nananek/kvm-board/README.md

# serial-km-emulator — CH9329 USB キーボード/マウスエミュレータ

MR-CH9329EMU-USB（マルツの CH9329 モジュール）の代替を JLCPCB の SMT 実装で作るための KiCad プロジェクトです。シリアル側とキーボード/マウス側の両方を USB Type-C にしています。

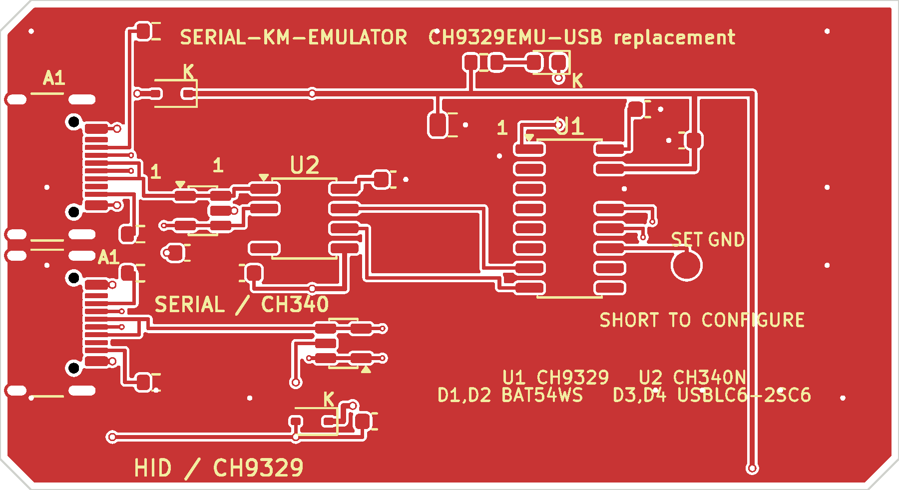
[picture p1: docs/pcb_top.png]
基板表面


- 基板: 57.6 × 31.4 × 1.6 mm、2 層。実物の FRISK ケース内寸（67.0 × 32.4 mm）の左側に 0.5 mm ずつ逃がして置き、右側はラッチ張り出しとのクリアランスを残した寸法です
- 回路図: [docs/schematic.pdf](docs/schematic.pdf)
- データシートとシルクの対応: [docs/datasheets.md](docs/datasheets.md)
- 配線図: [docs/pcb_routing.png](docs/pcb_routing.png)（GND ベタを消して配線を見やすくしたもの）
- 部品: 21 点、10 種類。すべて JLCPCB の在庫部品（2026-10 時点）。このほかに、実装しないテストパッドを 2 点置いています
- ファームウェア不要。CH9329 の内蔵ファームで動きます

## 仕様

| 項目 | 内容 |
| --- | --- |
| 基板寸法 | 57.6 × 31.4 mm、t1.6 mm、2 層 |
| コネクタ | USB Type-C レセプタクル ×2（HRO TYPE-C-31-M-12）。どちらも基板左端、上下に 5.0 mm ずつ振り分け |
| J1 (SERIAL) | CH340N 経由の USB シリアル。制御側 PC に接続 |
| J2 (HID) | CH9329 の USB HID。操作対象の PC に接続 |
| 給電 | どちらの Type-C からでも給電可。BAT54WS でダイオード OR |
| シリアル | 9600 bps / 8N1（CH9329 出荷時設定） |
| 動作モード | CH9329 Mode 0（キーボード + マウス + カスタム HID の複合デバイス）、プロトコルモード |
| 表示 | ACT# の LED（HID 側の USB 設定完了で点灯） |
| テストパッド | TP1 (SET) / TP2 (GND)。CH9329 の設定変更用 |
| シルク | 表: 部品名とピン極性、裏: リポジトリの QR コード |

J1/J2 はどちらもデバイス側（CC に 5.1k の Rd）です。ホスト PC とは C-to-C でも C-to-A でも接続できます。充電器は接続しないでください。

基板裏面にはリポジトリ（<https://github.com/nananek/serial-km-emulator>）の QR コードをシルクで入れています。ケースに組み込む前ならスマートフォンで読み取れます。

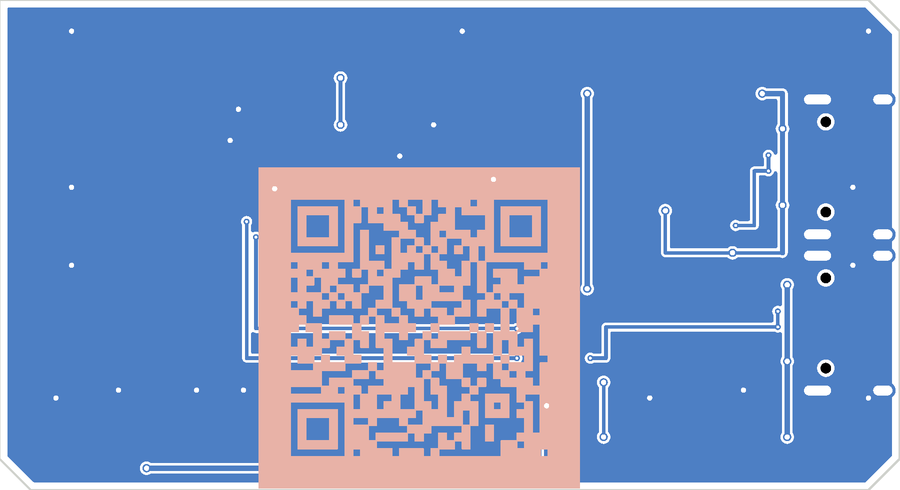
[picture p2: docs/pcb_bottom.png]
基板裏面


## 回路

```
制御側 PC ──Type-C(J1)── CH340N ──UART── CH9329 ──Type-C(J2)── 操作対象 PC
                              (TXD→RXD, RXD←TXD, 9600 8N1)
```

- CH9329: 5 V 給電。V33 に 0.1 µF、VCC に 0.1 µF。内蔵発振なので水晶なし。
- CH340N: 5 V 給電。V3 に 0.1 µF。内蔵クロックなので水晶なし。
- ESD: 各ポートに USBLC6-2SC6。クランプ用の VBUS ピンは各ポートのローカル VBUS に接続し、100nF (C6/C7) で GND にデカップリング。
- 5 V は BAT54WS ×2 で OR 接続。IC には約 4.7 V が入ります（CH340N の最低 4.0 V、CH9329 の最低 3.7 V の範囲内）。
- CH9329 の MODE0/MODE1、CFG0/CFG1、DEF、RST は未接続。内蔵プルアップ/プルダウンで Mode 0・プロトコルモード・9600 bps になります。UP は 5 V 動作なので未接続です。
- SET はテストパッド TP1 に、GND は TP2 に引き出しています。

### 設定の書き換え（TP1 / TP2）

U1 の右側に 1.7 mm のテストパッドを 2 つ出しています。

| パッド | 接続 | 位置 |
| --- | --- | --- |
| TP1 | CH9329 SET (pin 11) | U1 の右側、左のパッド |
| TP2 | GND | U1 の右側、右のパッド |

ピッチは 2.54 mm です。ピンセットやジャンパワイヤで TP1 と TP2 を短絡したまま、J1 側から WCH の設定ツールで書き換えます。書き換えが終わったら短絡を外してください。通常動作では SET は内蔵プルアップのままです。

## 部品表

`fab/bom_jlcpcb.csv` がそのまま JLCPCB の BOM です。

| 記号 | 値 | パッケージ | LCSC | 備考 |
| --- | --- | --- | --- | --- |
| J1, J2 | TYPE-C-31-M-12 | USB-C 16P | C165948 | HRO |
| U1 | CH9329 | SOP-16 | C2838834 | WCH |
| U2 | CH340N | SOP-8 | C2977777 | WCH |
| D1, D2 | BAT54WS | SOD-323 | C22629 | ショットキー |
| D3, D4 | USBLC6-2SC6 | SOT-23-6 | C7519 | ESD |
| R1–R4 | 5.1k | 0603 | C23186 | CC 用 |
| R5 | 1k | 0603 | C21190 | LED 用 |
| C1–C4, C6, C7 | 100nF | 0603 | C14663 | 50V X7R |
| C5 | 10uF | 0805 | C15850 | 25V X5R |
| LED1 | KT-0603R | 0603 | C2286 | 赤 |

基本部品（C23186、C21190、C14663、C15850、C2286）以外の 5 種類は拡張部品です。拡張部品は 1 種類あたりの実装手数料がかかります。

## JLCPCB での発注

基板:

- 2 層、57.6 × 31.4 mm、t1.6 mm、FR-4、HASL、1 oz
- 最小配線幅/間隔 0.15/0.15 mm、ビア 0.5/0.3 mm。データ線のエスケープに 0.35/0.15 mm のビアも使っています。JLCPCB の標準能力内です。

実装:

- 表面のみ、21 点。
- アップロードするファイル:
  - ガーバー: `fab/serial-km-emulator-gerbers.zip`
  - BOM: `fab/bom_jlcpcb.csv`
  - CPL: `fab/cpl_jlcpcb.csv`
- ガーバー、ドリル、CPL はすべて基板左下を原点にした座標です（KiCad のドリル/配置原点を使用）。ガーバー zip と CPL はセットで再アップロードしてください。JLCPCB の部品ライブラリ向けの回転補正を入れてあります（SO-8/SO-16 +270°、SOT-23-6 +270°。Type-C、SOD-323、LED、0603 は回転補正なし）。Type-C は基板側でフットプリントを 180° 回して開口を左外側、SMT パッドを基板内側に置いています。CPL は JLC 側の原点に合わせて X を 1.571 mm 補正しており、出力は J1/J2 とも 270°、位置はどちらも X 3.7 mm（Y は J1 20.7 mm、J2 10.7 mm）です。補正値は `scripts/make_jlc_files.py` にあります。実装プレビューで向きを確認してください。

注意:

- Type-C コネクタ (C165948) はシェル固定タブが THT 形状ですが、JLCPCB の SMT 実装部品リストに含まれている部品です。SMT 実装で発注できます。
- Type-C の VBUS パッドから 0.5/0.3 mm のビアをパッドの外側に置き、B.Cu で引き回しています。ビアはパッド内ではないため、via-in-pad の DFM 指摘はありません。VBUS は 2 接点ずつパッドが重なっているので、ビアは各コネクタ 2 個です。
- ガーバーは KiCad 10 の既定（X2、4.6 フォーマット）です。

## フリスクケースへの組み込み

基板外形は、実物の FRISK ケースの内寸からラッチ張り出しの分だけ右側をまっすぐ切り落とした **57.6 × 31.4 mm** です。左上・左下・右下の角は **2 mm の 45° パンチカット**で落とし、右上だけ直角に残しています。角丸のルーター加工より外形カットを安くするためです。

### 実寸確認用シート

紙に印刷してケースとの寸法を確認するときは [docs/print_check_a4.pdf](docs/print_check_a4.pdf) を使ってください。

- A4 横、1:1。印刷時は「実際のサイズ / 100%」を選び、「用紙に合わせる」は使わないでください。
- グレーベタが基板、その外側の明るいグレーの帯がケース内壁との 0.5 mm クリアランスです。切り抜いてトレイに落とせます。
- 右側の網掛けがケースのラッチ張り出しです。基板のまっすぐな右辺は、この張り出しから 0.5 mm 離して置きます。
- 下部の 100 mm 目盛りが 100 mm になっていなければ、印刷倍率がずれています。
- `python3 scripts/gen_print_sheet.py` で作り直せます（基板外形は `serial-km-emulator.kicad_pcb` の Edge.Cuts から読みます）。

### ケース寸法

2026-10 に実物の FRISK ケースを実測しました。

- 内寸: **67.0 × 32.4 mm**
- ケース肉厚: **1.0 mm**
- ラッチ張り出しの奥行き: **8.4 mm**
- ラッチ張り出しの高さ: **21.4 mm**（反対側の開口部は 11.0 mm）

基板は内寸から 0.5 mm ずつ逃がしたうえで、右側のラッチ張り出し 8.4 mm を避けるために **57.6 × 31.4 mm** にしています。右辺はラッチ用の切り欠きやローブを作らず、1 本の直線カットです。左上・左下・右下の角は 2 mm の 45° パンチカットで落とし、右上だけ直角に残します。基板をトレイの左・上・下に 0.5 mm ずつ寄せると、右辺はラッチ張り出しから 0.5 mm 離れ、トレイ右側の 8.9 mm は空きます。

参考として、公開されている 3D モデル（[FRISK-CASE.zip](https://try3dcg.world.coocan.jp/files/FRISK-CASE.zip)、`FRISK_CASE1.stl`）は内トレイ 66.4 × 32.4 mm、張り出し 7.8 × 20.3 mm でした。実物は長辺が 0.6 mm 大きいため、実測値を優先しています。モデル配布ページは [3D PRINT用モデルデータ — FRISK CASE](https://try3dcg.world.coocan.jp/note/3dPrint/3dPrint.html#FRISK-CASE) です。

ロット差があるため、初回は必ず現物合わせで確認してください。

### 基板の向きと切り欠き

- 基板のまっすぐな右辺をケースのラッチ張り出し側に向け、基板をトレイの左・上・下に 0.5 mm ずつ寄せて置きます。右辺と張り出しの間に 0.5 mm の隙間ができます。ラッチ用の切り欠きはありません。ケースの角の丸みは、左上・左下・右下の 2 mm パンチカットで逃がします（右上は直角のままです）。
- J1 (SERIAL) と J2 (HID) はどちらも基板左端にあり、上から **10.7 mm** と **20.7 mm** の位置（基板の y 方向中心 15.7 mm から 5.0 mm ずつ、ピッチ 10.0 mm）です。口は基板端から **1.5 mm** 外へ出ます。2 つの口は蓋の切り欠きに収まる位置にあるため、蓋は削らず、トレイ左側壁に約 20 × 4 mm の開口を **壁を貫通するように** 1 か所開けてください（2 つの口が 1.06 mm しか離れていないため、開口も 1 つに繋がります）。
- 基板端はケース内壁から 0.5 mm、肉厚は 1.0 mm なので、1.5 mm の口はケース外面とほぼ面一になります。プラグは壁の切り欠きを通ってコネクタに届きます。
- 切り欠きの外側を 0.3 mm 程度面取りすると、プラグの樹脂（オーバーモールド）が当たりにくくなり、奥まで挿しやすくなります。
- 基板は左・上・下の 0.5 mm を保って固定してください。右側に寄せるとラッチ張り出しに当たります。
- 基板をトレイに置いたとき、コネクタの口は基板面から約 1.6〜4.9 mm の高さに来ます。ケース底面からの高さはスペーサーで調整してください。
- 固定用の穴はありません。両面テープやスポンジで固定します。基板とトレイの間に 1 mm 程度のスペーサーを入れると、プラグの挿入量を稼げます（高さ方向の調整で、左右の出寸法には影響しません）。
- 実機のケースで必ず確認してください。内寸が違う場合は基板外形を調整できます。

## 使い方

1. J2 (HID) を操作対象の PC に接続します。キーボード/マウスとして認識され、LED が点灯します。
2. J1 (SERIAL) を制御側の PC に接続します。CH340 の USB シリアル（Linux なら `/dev/ttyUSB0`）として見えます。
3. 9600 bps / 8N1 で CH9329 のプロトコルを送ります。

'A' を押して離す例（CH9329 プロトコル、チェックサムは全バイトの和の下位 8 bit）:

```python
import serial
s = serial.Serial("/dev/ttyUSB0", 9600, timeout=1)
s.write(bytes.fromhex("57 AB 00 02 08 00 00 04 00 00 00 00 00 10"))  # press A
s.write(bytes.fromhex("57 AB 00 02 08 00 00 00 00 00 00 00 00 0C"))  # release
```

プロトコルの詳細は WCH の CH9329 データシートと「CH9329 シリアル通信プロトコル」を参照してください。

## 設計メモ

- シリアル側と HID 側は独立した USB デバイスです。2 台の PC の GND がケーブル経由で共通になります。これは元の MR-CH9329EMU-USB と同じです。
- ESD 保護素子の VBUS ピンは、ダイオード OR の前の各ポートのローカル VBUS に接続しています。VBUS-GND 間の 100nF (C6/C7) は USBLC6 の近くに置き、ESD 時のクランプ電圧を安定させています。
- Type-C の 4 つの VBUS 接点はすべて接続しています。VBUS パッドは 2 接点ずつ重なっているので、各コネクタ 2 個の 0.5/0.3 mm ビアをパッドの外側に置き、B.Cu で引き回しています。
- GND は両面ベタ。USB の D+/D- は全速 12 Mbps なので、特にインピーダンス制御はしていません。
- 部品番号のテキストは U1/U2 以外はシルクから外しています（実装は CPL で行うため）。
- J1/J2 は 10.0 mm ピッチで、シェル同士は 1.06 mm 空いています。ライブラリのコートヤード（±5.32 mm）はシェル（8.94 mm）より広く、2 個並べると 0.64 mm 重なるため、`serial-km-emulator.kicad_dru` でこの 2 個の組み合わせだけコートヤードの重なりを許可しています。

## ファイル構成

```
serial-km-emulator.kicad_pro  KiCad プロジェクト（DRC ルール・ネットクラス込み）
serial-km-emulator.kicad_dru  J1/J2 のコートヤード重なりだけを許可する DRC ルール
serial-km-emulator.kicad_sch  回路図
serial-km-emulator.kicad_pcb  基板（配線・ベタ済み）
lib/kvm.kicad_sym             シンボルライブラリ
lib/KVM.pretty/               フットプリント（KiCad 公式ライブラリから取得）
fp-lib-table                  KVM.pretty の登録
sym-lib-table                 kvm.kicad_sym の登録
fab/                          ガーバー zip、BOM、CPL、KiCad 位置ファイル
docs/                         回路図 PDF、基板画像
scripts/                      設計データ生成スクリプト
AGENT.md                      エージェント向けの再生成・検証手順
```

## 再生成

KiCad 10 の `kicad-cli` と Python の `pcbnew` が必要です。

```sh
python3 scripts/gen_sch.py     # 回路図
python3 scripts/gen_pcb.py     # 基板（ゼロから生成）
./scripts/export_fab.sh        # ガーバー、BOM、CPL
./scripts/gen_docs_images.sh   # docs の基板画像
```

リポジトリの URL を変えたときだけ、`python3 scripts/make_repo_qr.py` で `scripts/repo_qr.txt` を作り直してください（`qrcode` パッケージが必要です）。基板の生成はこのテキストファイルを読むだけなので、通常のビルドに `qrcode` は要りません。

Docker しかない場合は `scripts/kicad.sh` 経由で同じコマンドを実行できます。手順は [AGENT.md](AGENT.md) にまとめています。

`serial-km-emulator.kicad_pcb` は `scripts/gen_pcb.py` が生成します。GUI で直接編集すると次回の生成で上書きされるので、変更はスクリプト側に入れてください。回路図も同様に `scripts/gen_sch.py` から生成しています。

## 検証

- ERC: 0 件
- DRC: 0 件（エラー・警告とも）
- 回路図のネットリストと基板のパッドネットは一致
- `kicad-cli pcb drc` / `kicad-cli sch erc` で確認済み

## ライセンス

MIT。詳細は [LICENSE](LICENSE) を参照してください。

基板の製造・実装・ケース加工は自己責任で行ってください。特に Type-C のシェル固定タブ、VBUS パッド外のビア、ケースの切り欠きは、発注前に各自の環境で確認してください。
