nananek/kvm-board/docs/pcb_routing.png

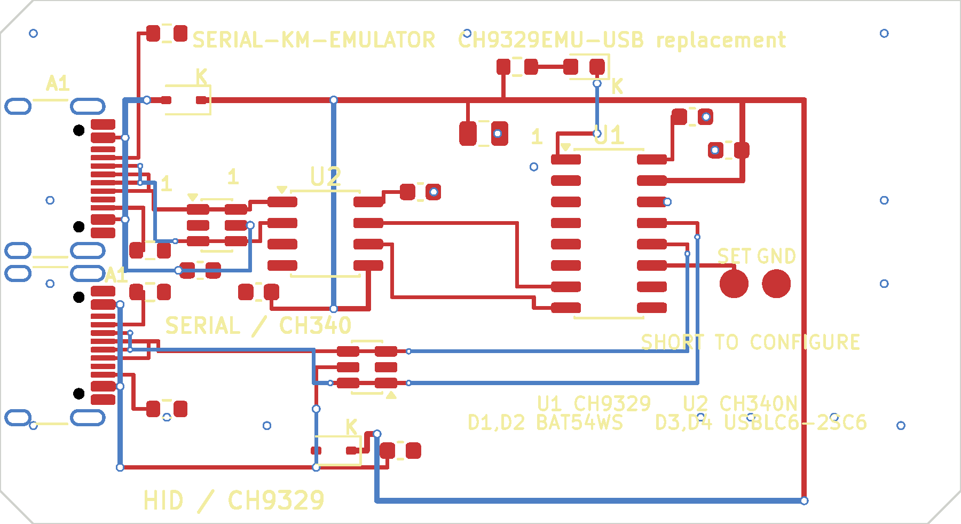
docs/pcb_routing.png
