nananek/kvm-board/fab/bom_jlcpcb.csv

Comment | Designator | Footprint | LCSC Part #
TYPE-C-31-M-12 | J1,J2 | USB_C_Receptacle_HRO_TYPE-C-31-M-12 | C165948
CH9329 | U1 | SO-16_3.9x9.9mm_P1.27mm | C2838834
CH340N | U2 | SO-8_3.9x4.9mm_P1.27mm | C2977777
BAT54WS | D1,D2 | D_SOD-323 | C22629
USBLC6-2SC6 | D3,D4 | SOT-23-6 | C7519
5.1k | R1,R2,R3,R4 | R_0603_1608Metric | C23186
1k | R5 | R_0603_1608Metric | C21190
KT-0603R | LED1 | LED_0603_1608Metric | C2286
100nF | C1,C2,C3,C4,C6,C7 | C_0603_1608Metric | C14663
10uF | C5 | C_0805_2012Metric | C15850
