nananek/kvm-board/docs/print_check_a4.pdf

# SERIAL-KM-EMULATOR / FRISK case fit check

Actual size (1:1). Print at 100% - do not use 'fit to page'.
If the 100 mm scale at the bottom does not measure 100 mm, the print is scaled. latch

J1

J2

SERIAL-KM-EMULATOR CH9329EMU-USB replacement

SERIAL / CH340

HID / CH9329

57.6

67.0 case inner

31.4

10.7

20.7

board (solid grey, 1:1)
0.5 mm case clearance (light grey)

connector centre line
case latch island (do not cover)

## HOW TO CHECK

1. Print this page at 100% / 'Actual size'.
2. Measure the 100 mm scale below with a steel rule.
3. Cut out the solid grey board and drop it into the tray.
4. Board 57.6 x 31.4, case inner 67.0 x 32.4. The light grey band is the 0.5 mm clearance to the left, top and bottom walls.
5. The right edge is one straight cut, 0.5 mm from the latch island. The right 8.9 mm of the tray stays empty. The top-left, bottom-left and bottom-right corners have 2 mm 45 degree punch cuts; the top-right stays square.
6. Both Type-C mouths are on the left edge at 10.7 and 20.7 mm from the top (5.0 mm either side of centre). Each mouth overhangs the edge by 1.5 mm.
7. Cut one 20 x 4 mm opening through the tray wall, centred between the two dashed centre lines. Both
ports sit inside the lid notch, so the lid is not cut.
Chamfer the outside by about 0.3 mm.
8. No mounting holes: use tape or foam with a 1 mm spacer.

### DIMENSIONS (mm)

board | 57.6 x 31.4 x 1.6
case | 67.0 x 32.4 inner, 1.0 wall
left/top/bottom gap 0.5
right edge 0.5 from the latch island corner cuts 2.0 x 45 deg (TL, BL, BR)
J1 / J2 centre 10.7 / 20.7 from the top connector pitch 10.0 (5.0 each side of centre)
mouth | 1.5 past the left edge
0 | 50 | 100

100 mm scale check (mm)

Generated by scripts/gen_print_sheet.py from serial-km-emulator.kicad_pcb
