nananek/kvm-board/docs/schematic.pdf

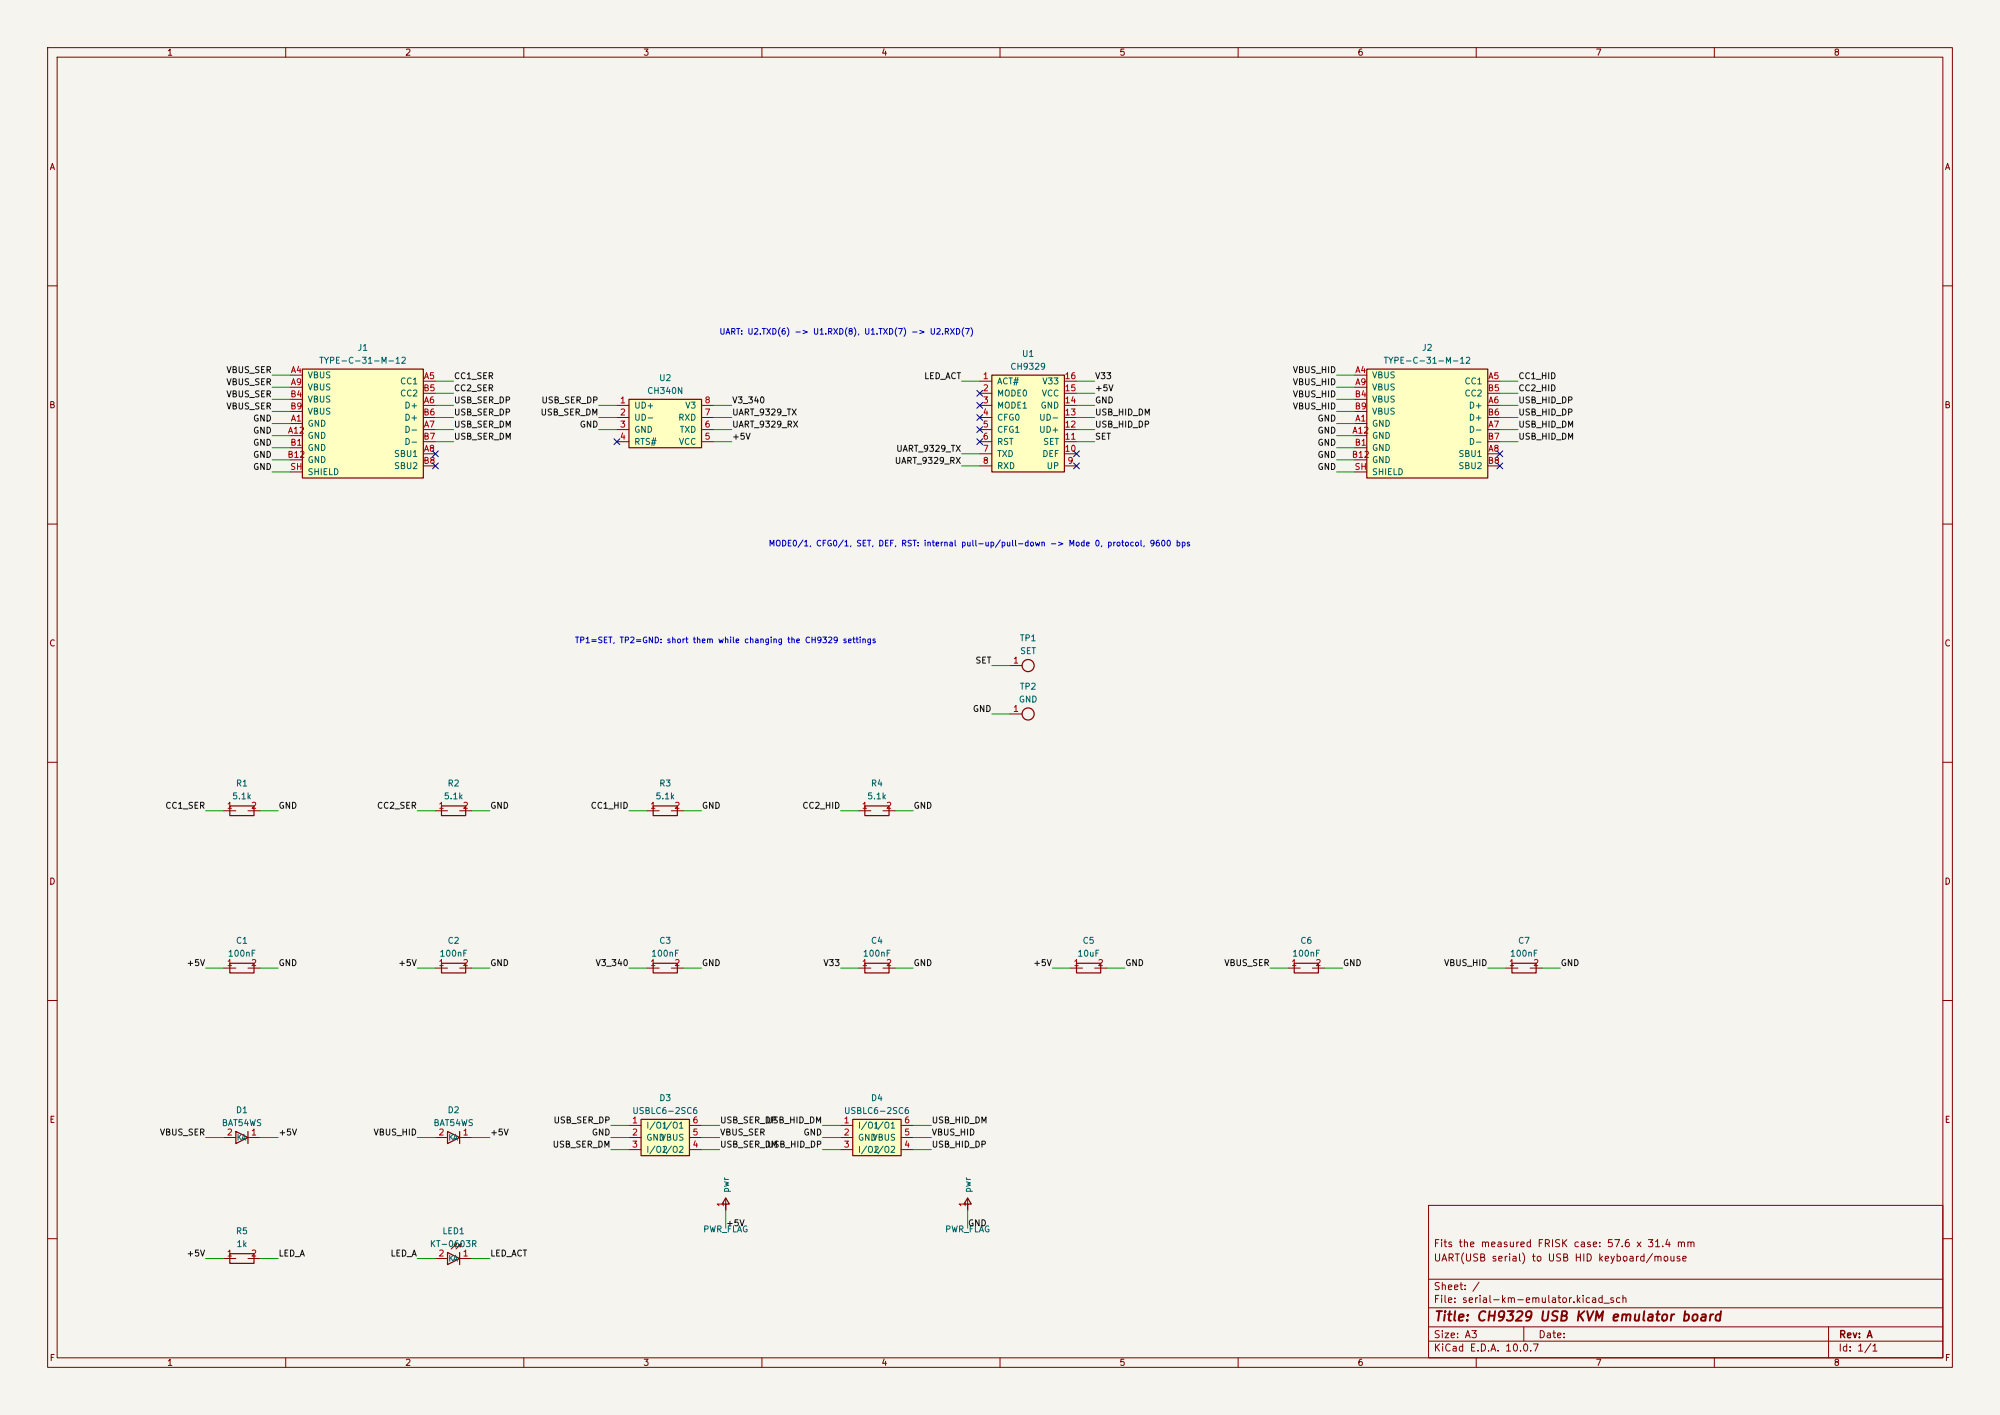
[picture p4: page 1]

MODE0/1, CFG0/1, SET, DEF, RST: internal pull-up/pull-down -> Mode 0, protocol, 9600 bps UART: U2.TXD(6) -> U1.RXD(8), U1.TXD(7) -> U2.RXD(7)

TP1=SET, TP2=GND: short them while changing the CH9329 settings

Fits the measured FRISK case: 57.6 x 31.4 mm
UART(USB serial) to USB HID keyboard/mouse

Sheet: /
File: serial-km-emulator.kicad_sch
Title: CH9329 USB KVM emulator board

Size: A3 | Rev: A | F Date:
KiCad E.D.A. 10.0.7 | Id: 1/1
