nananek/kvm-board/serial-km-emulator.kicad_pcb

## KiCad design serial-km-emulator.kicad_pcb (2026-10-31)

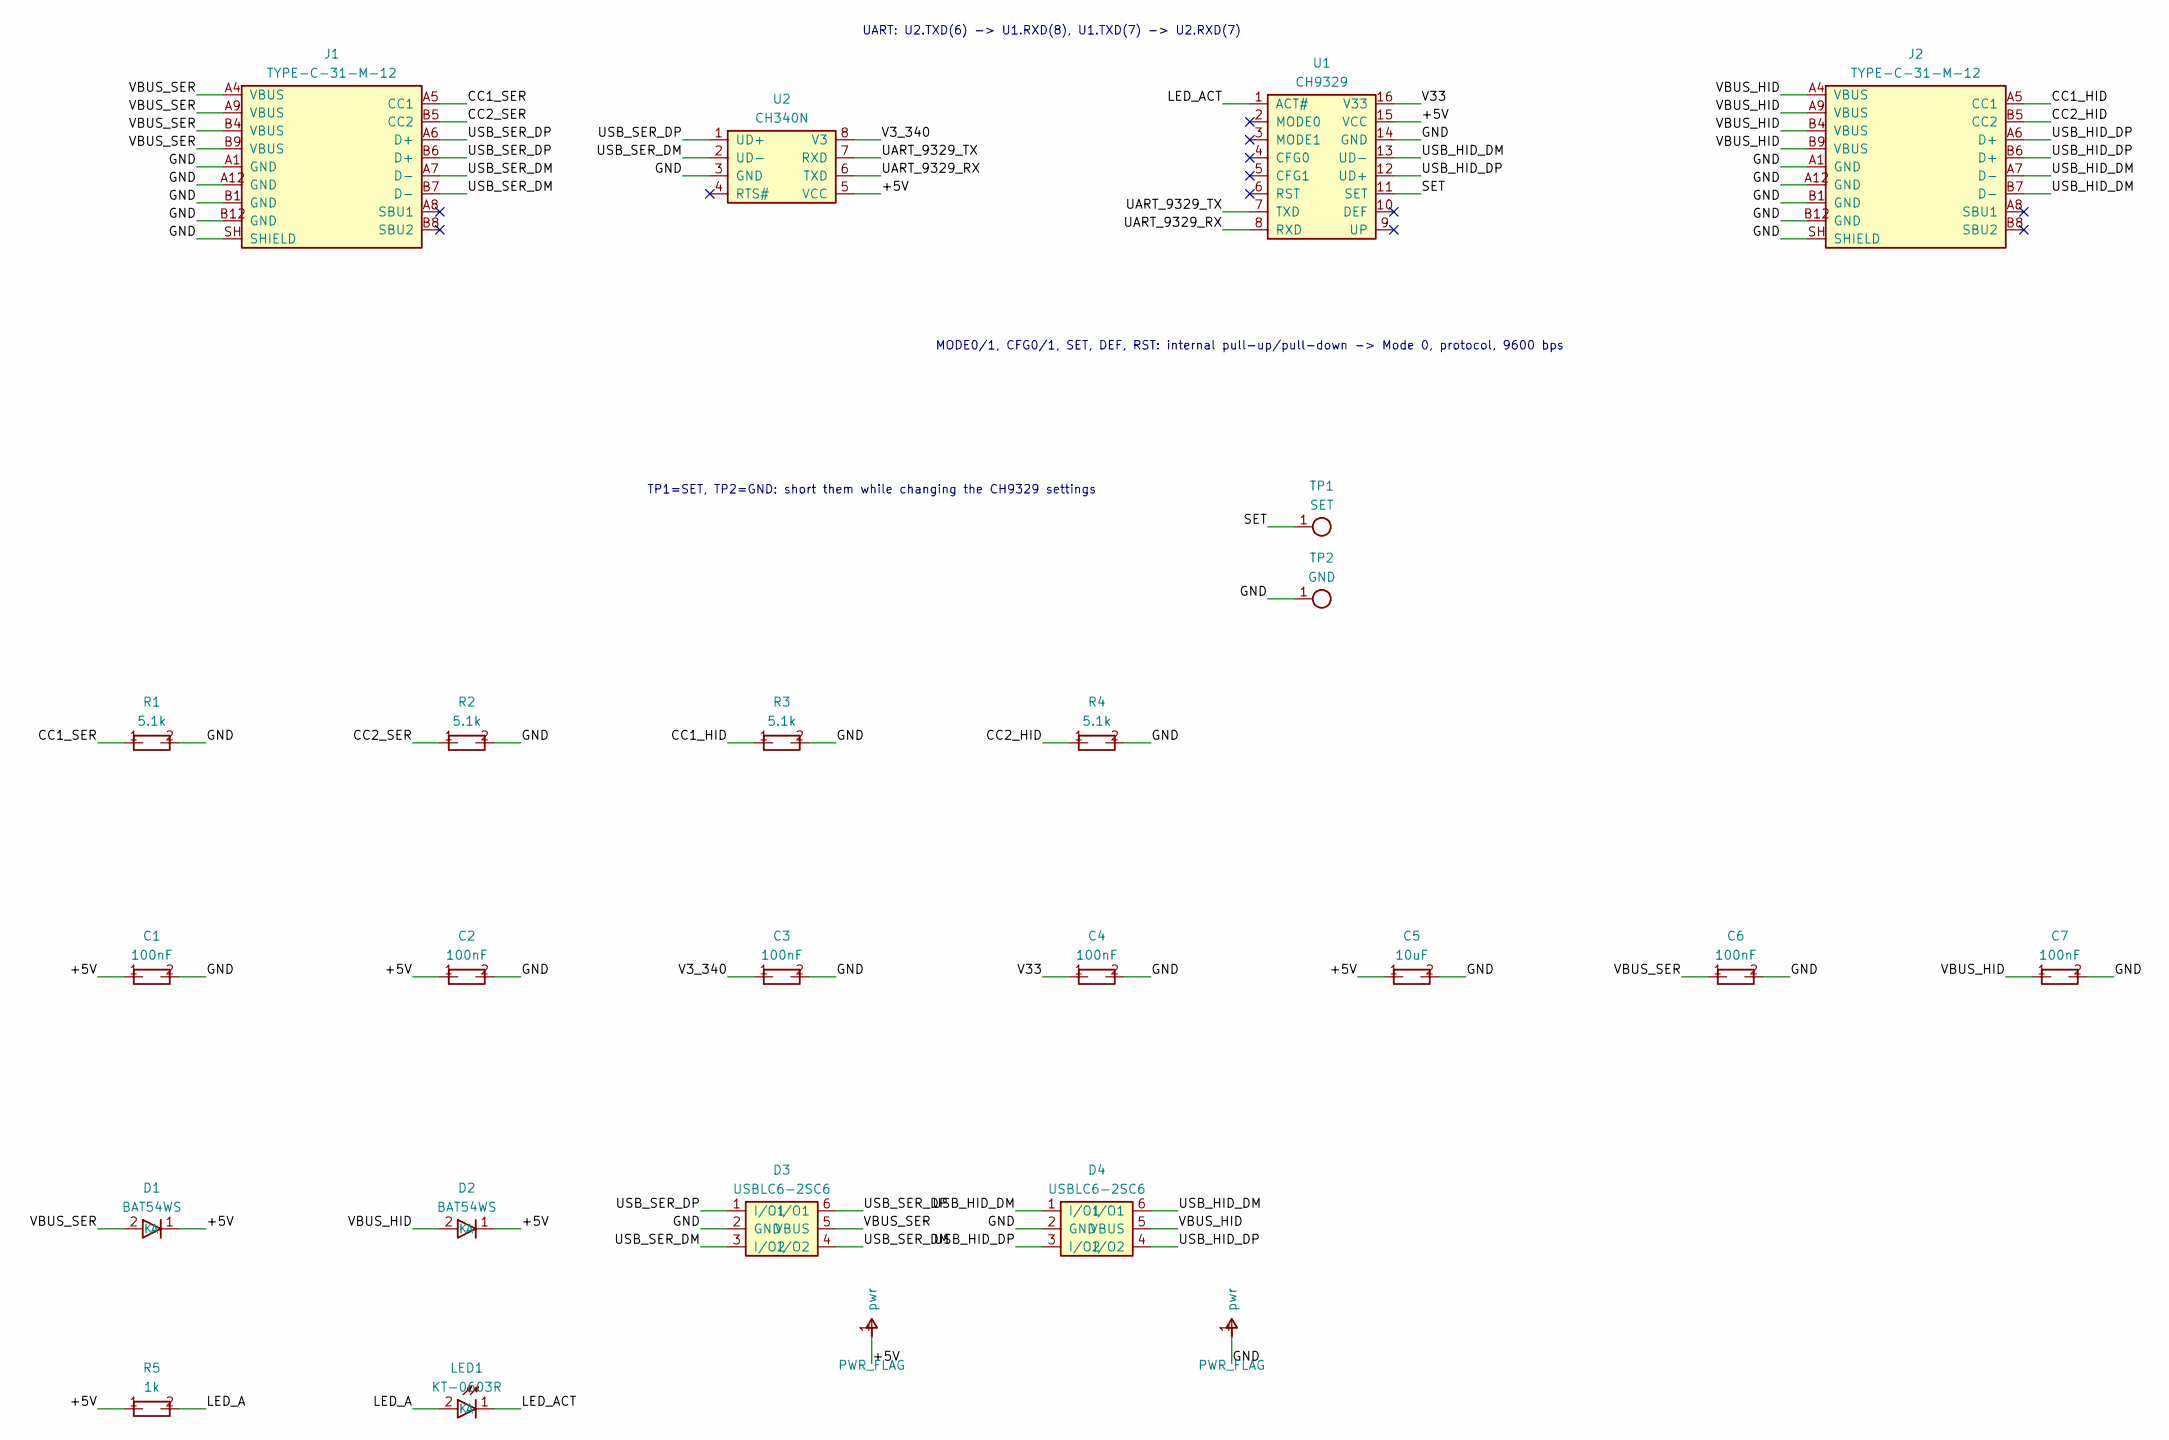
[picture p5: schematic serial-km-emulator.kicad_sch, CH9329 USB KVM emulator board]

Parts:
C1, C2, C3, C4, C6, C7: 100nF; C_0603_1608Metric; LCSC C14663
C5: 10uF; C_0805_2012Metric; LCSC C15850
D1, D2: BAT54WS; D_SOD-323; LCSC C22629
D3, D4: USBLC6-2SC6; SOT-23-6; LCSC C7519
J1, J2: TYPE-C-31-M-12; USB_C_Receptacle_HRO_TYPE-C-31-M-12; LCSC C165948
LED1: KT-0603R; LED_0603_1608Metric; LCSC C2286
R1, R2, R3, R4: 5.1k; R_0603_1608Metric; LCSC C23186
R5: 1k; R_0603_1608Metric; LCSC C21190
TP1: SET; TestPoint_1P
TP2: GND; TestPoint_1P
U1: CH9329; SO-16_3.9x9.9mm_P1.27mm; LCSC C2838834
U2: CH340N; SO-8_3.9x4.9mm_P1.27mm; LCSC C2977777

Connections:
+5V: C1.1, C2.1, C5.1, D1.1 (K), D2.1 (K), R5.1, U1.15 (VCC), U2.5 (VCC)
CC1_HID: J2.A5 (CC1), R3.1
CC1_SER: J1.A5 (CC1), R1.1
CC2_HID: J2.B5 (CC2), R4.1
CC2_SER: J1.B5 (CC2), R2.1
GND: C1.2, C2.2, C3.2, C4.2, C5.2, C6.2, C7.2, D3.2 (GND), D4.2 (GND), J1.A1 (GND), J1.A12 (GND), J1.B1 (GND), J1.B12 (GND), J1.SH (SHIELD), J2.A1 (GND), J2.A12 (GND), J2.B1 (GND), J2.B12 (GND), J2.SH (SHIELD), R1.2, R2.2, R3.2, R4.2, TP2.1, U1.14 (GND), U2.3 (GND)
LED_A: LED1.2 (A), R5.2
LED_ACT: LED1.1 (K), U1.1 (ACT#)
SET: TP1.1, U1.11 (SET)
UART_9329_RX: U1.8 (RXD), U2.6 (TXD)
UART_9329_TX: U1.7 (TXD), U2.7 (RXD)
USB_HID_DM: D4.1 (I/O1), D4.6 (I/O1), J2.A7 (D-), J2.B7 (D-), U1.13 (UD-)
USB_HID_DP: D4.3 (I/O2), D4.4 (I/O2), J2.A6 (D+), J2.B6 (D+), U1.12 (UD+)
USB_SER_DM: D3.3 (I/O2), D3.4 (I/O2), J1.A7 (D-), J1.B7 (D-), U2.2 (UD-)
USB_SER_DP: D3.1 (I/O1), D3.6 (I/O1), J1.A6 (D+), J1.B6 (D+), U2.1 (UD+)
V3_340: C3.1, U2.8 (V3)
V33: C4.1, U1.16 (V33)
VBUS_HID: C7.1, D2.2 (A), D4.5 (VBUS), J2.A4 (VBUS), J2.A9 (VBUS), J2.B4 (VBUS), J2.B9 (VBUS)
VBUS_SER: C6.1, D1.2 (A), D3.5 (VBUS), J1.A4 (VBUS), J1.A9 (VBUS), J1.B4 (VBUS), J1.B9 (VBUS)

Notes on the sheet:
UART: U2.TXD(6) -> U1.RXD(8), U1.TXD(7) -> U2.RXD(7)
MODE0/1, CFG0/1, SET, DEF, RST: internal pull-up/pull-down -> Mode 0, protocol, 9600 bps
TP1=SET, TP2=GND: short them while changing the CH9329 settings

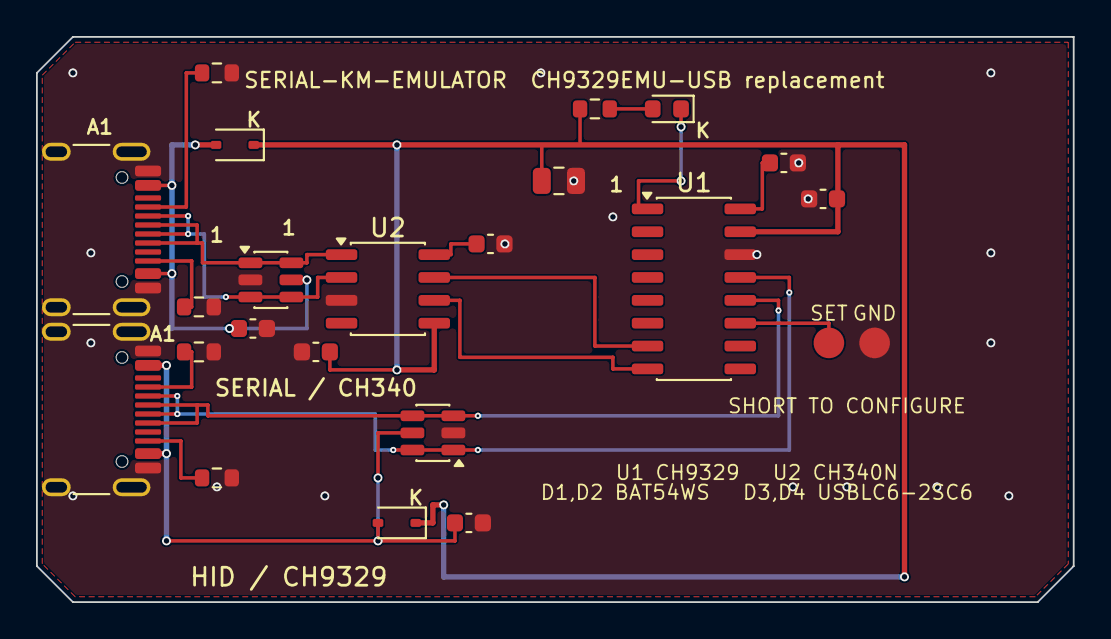
[picture p6: board serial-km-emulator.kicad_pcb from above]

Board: 2 copper layers, 57.6 x 31.4 mm, 23 parts (0 on the bottom side), 19 nets.
