nananek/kvm-board/(commit log)

2026-10-30 Add CH9329 USB keyboard/mouse emulator board
    56 x 27 mm two-layer KiCad board with two USB Type-C ports:
    CH340N USB serial on J1 and CH9329 HID on J2. Diode-OR power,
    ESD protection, and JLCPCB fabrication outputs.
    [bom_jlcpcb.csv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]
2026-10-30 Correct CPL rotations for JLCPCB part library
    [cpl_jlcpcb.csv, kvm-board-B_Cu.gbl, kvm-board-B_Mask.gbs, kvm-board-B_Paste.gbp, kvm-board-B_Silkscreen.gbo, kvm-board-Edge_Cuts.gm1, kvm-board-F_Cu.gtl, kvm-board-F_Mask.gts]
2026-10-30 Use a common bottom-left origin for gerbers and CPL
    This removes the 27 mm Y offset that made JLCPCB ask about
    auto-aligning the component placement.
    [kvm-board-B_Cu.gbl, kvm-board-B_Mask.gbs, kvm-board-B_Paste.gbp, kvm-board-B_Silkscreen.gbo, kvm-board-Edge_Cuts.gm1, kvm-board-F_Cu.gtl, kvm-board-F_Mask.gts, kvm-board-F_Paste.gtp]
2026-10-30 Fix ESD clamp rails and add local VBUS decoupling
    Connect the USBLC6 VBUS pins to each port's local VBUS instead of the
    common +5V rail, and add 100 nF at each ESD array as recommended by the
    ST datasheet. Add a pin-level review document.
    Verified: ERC 0, DRC 0, schematic/PCB netlists match.
    [bom_jlcpcb.csv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]
2026-10-30 Document UART crossover and strap-pin defaults on the schematic
    [kvm-board.kicad_sch]
2026-10-30 Clarify Frisk case variants behind the board outline
2026-10-30 Add pin-1/polarity silkscreen marks and datasheet reference
    [kvm-board-B_Cu.gbl, kvm-board-B_Mask.gbs, kvm-board-B_Paste.gbp, kvm-board-B_Silkscreen.gbo, kvm-board-Edge_Cuts.gm1, kvm-board-F_Cu.gtl, kvm-board-F_Mask.gts, kvm-board-F_Paste.gtp]
2026-10-30 Fix KiCad 10 board generation and the J1 A1 mark
    - generate vias without the removed pcbnew.VIATYPE_* constants and fill
    zones after reloading the saved board, so gen_pcb.py runs on KiCad 10
    - move the J1 A1 silkscreen mark to the A1 end of the connector
    - correct the board size in the layout comment (56 x 27 mm)
    - build the gerber zip with Python instead of the zip command
    - regenerate the board, fabrication outputs, and board images
    [kvm-board-B_Cu.gbl, kvm-board-B_Mask.gbs, kvm-board-B_Paste.gbp, kvm-board-B_Silkscreen.gbo, kvm-board-Edge_Cuts.gm1, kvm-board-F_Cu.gtl, kvm-board-F_Mask.gts, kvm-board-F_Paste.gtp]
2026-10-30 fix: adjust D3 and D4 JLCPCB placement rotations
    [cpl_jlcpcb.csv]
2026-10-30 Move the J1 A1 silkscreen mark clear of the connector
    The J1 A1 mark was placed 4.2 mm from the connector centre, i.e. inside
    the 8.94 mm wide body, so the JLCPCB 3D preview showed only the bottom
    edge of the text. Move it to 5.5 mm so the glyphs sit 0.55 mm clear of
    the body and 0.25 mm clear of the footprint's silkscreen outline, then
    regenerate the Gerbers, drill files and position file with KiCad 10.0.7.
    DRC reports 0 violations.
    [kvm-board-B_Cu.gbl, kvm-board-B_Mask.gbs, kvm-board-B_Paste.gbp, kvm-board-B_Silkscreen.gbo, kvm-board-Edge_Cuts.gm1, kvm-board-F_Cu.gtl, kvm-board-F_Mask.gts, kvm-board-F_Paste.gtp]
2026-10-30 Add scripted KiCad tooling and document the workflow
    - scripts/kicad.sh runs kicad-cli / pcbnew in the pinned kicad/kicad:10.0
    container and falls back to --user 0:0 when rootless Docker maps the
    bind mount to root
    - scripts/gen_docs_images.sh builds the three docs/pcb_*.png images from
    kicad-cli PDF plots (Ghostscript rasterises them)
    - scripts/strip_zones.py makes a zone-free copy for the routing image
    - AGENT.md documents regeneration, DRC/ERC and the commit/PR flow
2026-10-30 Regenerate the board images with kicad-cli
    Built with scripts/gen_docs_images.sh, so the images now show the moved
    J1 A1 silkscreen mark.
2026-10-30 Move the Type-C pads to the rear of the connector
    Rotate J1/J2 by 180 degrees and shift them outward so the SMT pads sit at the rear of the connector while the mouth stays at the board edge. The CPL values for J1/J2 stay at 5.2/50.8 mm and 270/90 degrees. U1/U2, D3/D4 and two caps move to keep the fanout routable; the CPL is updated for those parts. DRC/ERC are clean.
    [cpl_jlcpcb.csv, kvm-board-B_Cu.gbl, kvm-board-B_Mask.gbs, kvm-board-B_Paste.gbp, kvm-board-B_Silkscreen.gbo, kvm-board-Edge_Cuts.gm1, kvm-board-F_Cu.gtl, kvm-board-F_Mask.gts]
2026-10-30 Fit the board outline to the published FRISK-CASE 3D model
    Reshape the PCB to 65.4 x 31.4 mm with a 6.8 x 19.8 mm latch notch measured from the published FRISK_CASE1.stl, move J2 to the upper-right lobe, and swap D4's two identical USBLC6 channels so the J2 fanout stays planar. Regenerate the schematic, board images, gerbers, CPL and position files. DRC and ERC are clean.
    [cpl_jlcpcb.csv, kvm-board-B_Cu.gbl, kvm-board-B_Mask.gbs, kvm-board-B_Paste.gbp, kvm-board-B_Silkscreen.gbo, kvm-board-Edge_Cuts.gm1, kvm-board-F_Cu.gtl, kvm-board-F_Mask.gts]
2026-10-30 Restore J2 silkscreen on the wider board outline
    The silk-to-fab filter still used the old 56 mm board width, so all of J2's silkscreen was moved to the fab layer after the outline change. Use the current board width, regenerate the silkscreen gerber and the board images, and update the documented PDF page size.
    [kvm-board-B_Cu.gbl, kvm-board-B_Mask.gbs, kvm-board-B_Paste.gbp, kvm-board-B_Silkscreen.gbo, kvm-board-Edge_Cuts.gm1, kvm-board-F_Cu.gtl, kvm-board-F_Mask.gts, kvm-board-F_Paste.gtp]
2026-10-30 Add a 1:1 A4 print sheet for checking the case fit
    Draw the Edge.Cuts outline at actual size on an A4 landscape page with the case tray outline, the connector centres, dimensions and a 100 mm scale check. The sheet is generated by scripts/gen_print_sheet.py with the standard library only, so it needs no KiCad install.
2026-10-30 Move J1/J2 out so plugs clear the case wall
    J1 now overhangs the left edge by 1.5 mm and J2 the right edge by 1.4 mm. J2 stops at 1.4 mm because its front shell pad would otherwise clash with the top-right R2 corner; it also moves down 0.2 mm. Adjust the J1 VBUS/CC1 escapes for the new pad positions and regenerate the board, fabrication outputs, images and 1:1 print sheet. DRC and ERC are clean.
    [cpl_jlcpcb.csv, kvm-board-B_Cu.gbl, kvm-board-B_Mask.gbs, kvm-board-B_Paste.gbp, kvm-board-B_Silkscreen.gbo, kvm-board-Edge_Cuts.gm1, kvm-board-F_Cu.gtl, kvm-board-F_Mask.gts]
2026-10-30 Add SET/GND test pads and a repository QR code
    TP1/TP2 break out the CH9329 SET pin and GND so the WCH config tool can be used without soldering to U1. Both are bare 1.7 mm pads on 2.54 mm pitch and are excluded from the BOM and CPL.
    The bottom silkscreen now carries a QR code for https://github.com/nananek/kvm-board. The matrix is checked in as scripts/repo_qr.txt; scripts/make_repo_qr.py regenerates it when the URL changes.
    [kvm-board-B_Cu.gbl, kvm-board-B_Mask.gbs, kvm-board-B_Paste.gbp, kvm-board-B_Silkscreen.gbo, kvm-board-Edge_Cuts.gm1, kvm-board-F_Cu.gtl, kvm-board-F_Mask.gts, kvm-board-F_Paste.gtp]
2026-10-30 Tidy HID USB D- routing
    [kvm-board.kicad_pcb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]
2026-10-30 Restore the B.Cu zone fill produced by gen_pcb.py
    The committed board had a separately refilled B.Cu pour, so running
    scripts/gen_pcb.py changed the archived B.Cu gerber. Re-export the board and
    fab data from the generator output so regeneration is a no-op.
    [kvm-board.kicad_pcb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]
2026-10-31 Stop the print sheet notes from overlapping the dimensions
2026-10-31 Fit the board to the measured FRISK case
    Widen the board to 66.0 x 31.4 mm for the 67.0 x 32.4 mm inner tray, cut an 8.4 x 20.4 mm latch notch with a square inner corner, and centre J1 at 15.7 mm so its terminal row is on the board centreline. Keep both connector mouths at the case surface (J1 1.5 mm, J2 1.44 mm overhang; 1.0 mm wall plus 0.5 mm gap). Move R1 down 0.3 mm to clear J1's courtyard and adjust the J1 escapes. Make the A4 fit sheet a solid grey board with a light grey 0.5 mm clearance band instead of outlines. Regenerate the PCB, fabrication files, images and schematic. DRC and ERC are clean.
    [cpl_jlcpcb.csv, kvm-board-B_Cu.gbl, kvm-board-B_Mask.gbs, kvm-board-B_Paste.gbp, kvm-board-B_Silkscreen.gbo, kvm-board-Edge_Cuts.gm1, kvm-board-F_Cu.gtl, kvm-board-F_Mask.gts]
2026-10-31 Leave clearance in the latch opening
    Reduce the upper-right lobe from 11.0 to 10.5 mm (notch 8.4 x 20.9 mm) so the board is 0.5 mm smaller than the measured 11.0 mm opening. Nudge J2 0.16 mm left and 0.22 mm up to keep its shell pads 0.2 mm from the notch edge and the rounded corner; the J2 mouth overhang becomes 1.28 mm. Regenerate the PCB, fabrication files, images and print sheet. DRC and ERC are clean.
    [cpl_jlcpcb.csv, kvm-board-B_Cu.gbl, kvm-board-B_Mask.gbs, kvm-board-B_Paste.gbp, kvm-board-B_Silkscreen.gbo, kvm-board-Edge_Cuts.gm1, kvm-board-F_Cu.gtl, kvm-board-F_Mask.gts]
2026-10-31 Spell out the latch clearance on the fit sheet
    Make the print sheet state that the 10.5 mm lobe leaves 0.5 mm to the latch island, and add the missing unit to the lobe dimension.
2026-10-31 Simplify the outline and put both Type-C ports on the left
    Cut the whole right side back to the old latch-notch line, so the board is
    57.6 x 31.4 mm with one straight right edge and no lobe. Move J2 next to J1
    on the left edge, 12.0 mm apart around the centre line, and reroute the HID
    side, VBUS, CC and SET test pad around the new placement. Regenerate the
    PCB, fabrication files, images and the 1:1 fit sheet, and update the notes.
    [cpl_jlcpcb.csv, kvm-board-B_Cu.gbl, kvm-board-B_Mask.gbs, kvm-board-B_Paste.gbp, kvm-board-B_Silkscreen.gbo, kvm-board-Edge_Cuts.gm1, kvm-board-F_Cu.gtl, kvm-board-F_Mask.gts]
2026-10-31 Make the routing orthogonal and update the schematic size note
    Replace the remaining diagonal copper segments with horizontal and vertical
    runs, including the HID data pairs, CC legs, D2 supply leg, U2 VCC, SET and
    the LED via jog. Update the schematic title block to 57.6 x 31.4 mm and
    regenerate the schematic, fab files and board images.
    [kvm-board-B_Cu.gbl, kvm-board-B_Mask.gbs, kvm-board-B_Paste.gbp, kvm-board-B_Silkscreen.gbo, kvm-board-Edge_Cuts.gm1, kvm-board-F_Cu.gtl, kvm-board-F_Mask.gts, kvm-board-F_Paste.gtp]
2026-10-31 Move the Type-C ports inward to fit the lid notch
    J1/J2 move from +/-6.0 mm to +/-5.0 mm around the board centre (pitch 12.0 -> 10.0 mm), so both mouths sit inside the FRISK lid notch and only the tray wall needs an opening. The shells keep 1.06 mm between them. Re-route the J1/J2 VBUS, D+/D- and CC escapes orthogonally, add a J1/J2-only courtyard DRC rule, and regenerate the fab files, images and print sheet.
    [cpl_jlcpcb.csv, kvm-board-B_Cu.gbl, kvm-board-B_Mask.gbs, kvm-board-B_Paste.gbp, kvm-board-B_Silkscreen.gbo, kvm-board-Edge_Cuts.gm1, kvm-board-F_Cu.gtl, kvm-board-F_Mask.gts]
2026-10-31 Use punch cuts for the three rounded board corners
    Replace the 2 mm radius on the top-left and bottom-left corners with 2 mm 45 degree punch cuts, and add the same cut to the bottom-right corner where the case fillet needs clearance. The top-right stays square beside the latch island. Regenerate the PCB, fabrication files, board images and 1:1 fit sheet.
    [kvm-board-B_Cu.gbl, kvm-board-B_Mask.gbs, kvm-board-B_Paste.gbp, kvm-board-B_Silkscreen.gbo, kvm-board-Edge_Cuts.gm1, kvm-board-F_Cu.gtl, kvm-board-F_Mask.gts, kvm-board-F_Paste.gtp]
2026-10-31 Rename the project to serial-km-emulator
    Update the repository URL in the README and docs, regenerate the 41x41 silkscreen QR code (now 0.5 mm modules) and the top silkscreen title, and rename the KiCad project and fabrication files to match.
    [kvm-board-B_Silkscreen.gbo, serial-km-emulator-B_Cu.gbl, serial-km-emulator-B_Mask.gbs, serial-km-emulator-B_Paste.gbp, serial-km-emulator-B_Silkscreen.gbo, serial-km-emulator-Edge_Cuts.gm1, serial-km-emulator-F_Cu.gtl, serial-km-emulator-F_Mask.gts]
